szumsky/Low-Power-Internet-Radio/README.md

# Low-Power-Internet-Radio
projekt badawczy 22/23

na razie puściutko
