szumsky/Low-Power-Internet-Radio/hardware/105450-0101/105450-0101.step

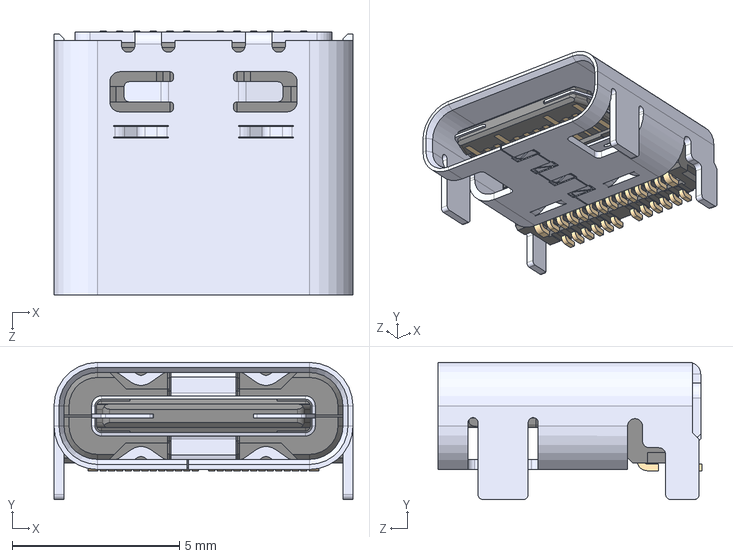
[picture p1: CAD file, 2022-08-20]
hardware/105450-0101/105450-0101.step
8.94 x 4.10 x 7.90 mm
