szumsky/Low-Power-Internet-Radio/(list of files, drawings)

Other design files:
hardware/reference/ESP32-DevKitC-V4_Reference_Design/02_PCB Layout/ESP32-DevKitC-V4_20171206A.pcb
