szumsky/Low-Power-Internet-Radio/hardware/radio.kicad_pcb

## KiCad design hardware/radio.kicad_pcb (2023-05-23)

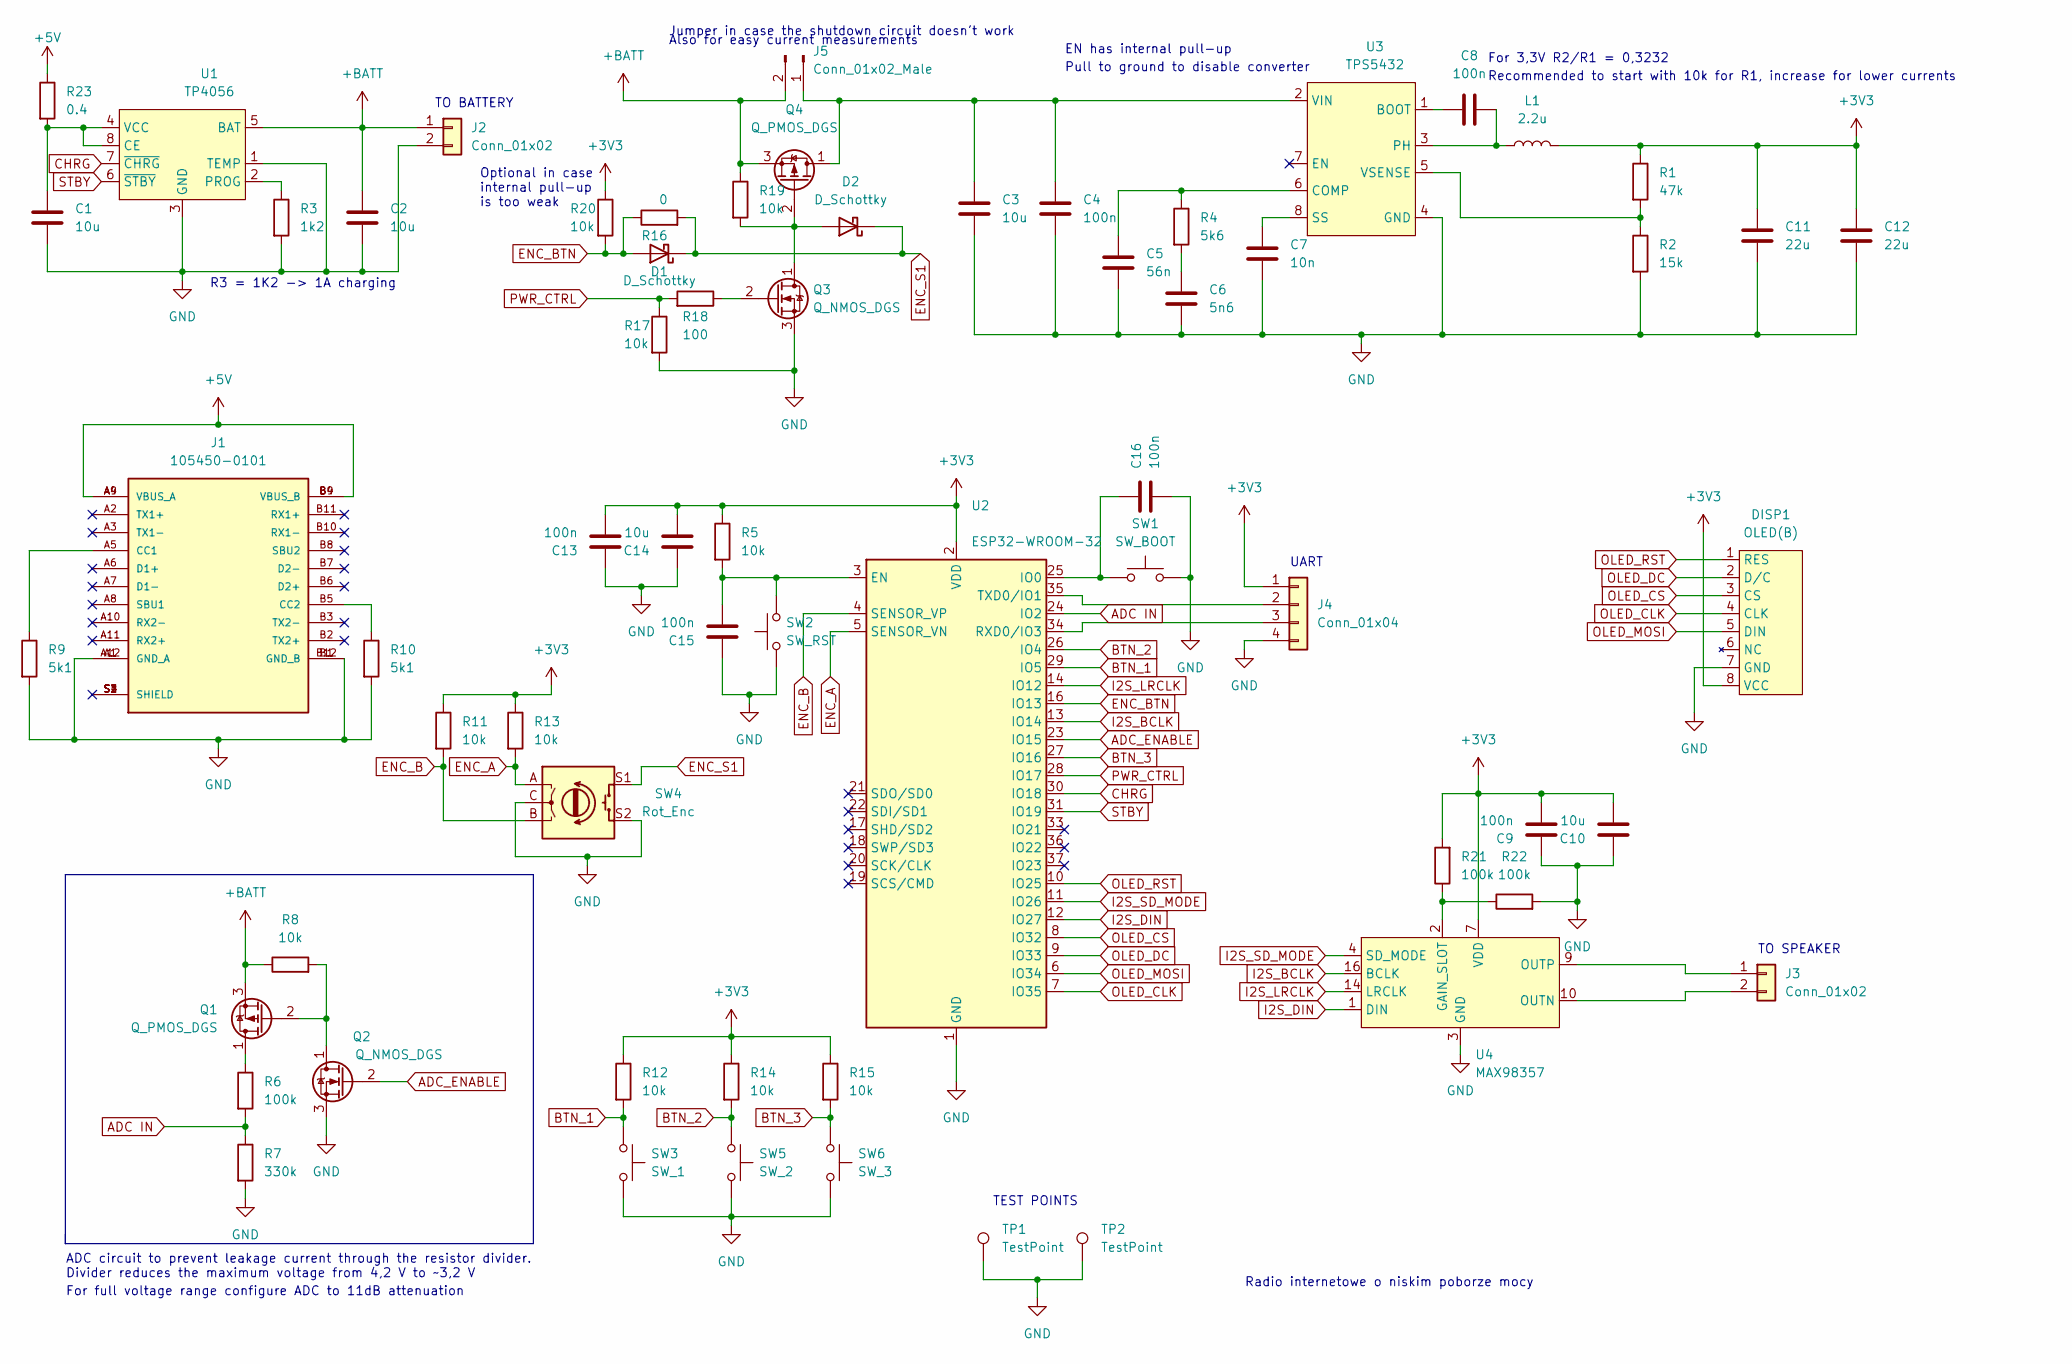
[picture p2: schematic radio.kicad_sch]

Parts:
C1, C2, C3, C10, C14: 10u; C_1206_3216Metric
C4, C9, C13, C15, C16: 100n; C_0603_1608Metric
C5: 56n; C_0603_1608Metric
C6: 5n6; C_0603_1608Metric
C7: 10n; C_0603_1608Metric
C8: 100n; C_0603_1608Metric; Voltage rating >10V
C11, C12: 22u; C_1206_3216Metric
D1, D2: D_Schottky; D_SMA
DISP1: OLED(B); waveshare_oled
J1: 105450-0101; MOLEX_105450-0101; PARTREV A7
J2, J3: Conn_01x02; PinHeader_1x02_P2.54mm_Vertical
J4: Conn_01x04; PinHeader_1x04_P2.54mm_Vertical
J5: Conn_01x02_Male; PinHeader_1x02_P2.54mm_Horizontal
L1: 2.2u; DJNR6028-2R2-S
Q1, Q4: Q_PMOS_DGS; SOT-23
Q2, Q3: Q_NMOS_DGS; SOT-23
R1: 47k; R_0603_1608Metric
R2: 15k; R_0603_1608Metric
R3: 1k2; R_0603_1608Metric
R4: 5k6; R_0603_1608Metric
R5, R8, R11, R12, R13, R14, R15, R17, R19, R20: 10k; R_0603_1608Metric
R6, R21, R22: 100k; R_0603_1608Metric
R7: 330k; R_0603_1608Metric
R9, R10: 5k1; R_0603_1608Metric
R16: 0; R_0603_1608Metric
R18: 100; R_0603_1608Metric
R23: 0.4; R_1210_3225Metric; Power rating 0.5 W
SW1: SW_BOOT; SW_Push_1P1T_NO_6x6mm_H9.5mm
SW2: SW_RST; SW_Push_1P1T_NO_6x6mm_H9.5mm
SW3: SW_1; SW_Push_1P1T_NO_6x6mm_H9.5mm
SW4: Rot_Enc; RotaryEncoder_Alps_EC12E-Switch_Vertical_H20mm_CircularMoun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
SW5: SW_2; SW_Push_1P1T_NO_6x6mm_H9.5mm
SW6: SW_3; SW_Push_1P1T_NO_6x6mm_H9.5mm
TP1, TP2: TestPoint; TestPoint_Loop_D2.50mm_Drill1.0mm
U1: TP4056; SOP-8-1EP_4.57x4.57mm_P1.27mm_EP4.57x4.45mm
U2: ESP32-WROOM-32
U3: TPS5432; TI_SO-PowerPAD-8
U4: MAX98357; TQFN-16-1EP_3x3mm_P0.5mm_EP1.23x1.23mm

Connections:
+3V3: C9.2, C10.2, C11.1, C12.1, C13.2, C14.2, DISP1.8 (VCC), J4.1, L1.2, R1.1, R5.1, R11.1, R12.1, R13.1, R14.1, R15.1, R20.1, R21.2, U2.2 (VDD), U4.7 (VDD)
+5V: J1.A4 (VBUS_A), J1.A9 (VBUS_A), J1.B4 (VBUS_B), J1.B9 (VBUS_B), R23.1
+BATT: C2.1, J2.1, J5.2, Q1.3 (S), Q4.3 (S), R8.1, R19.1, U1.5 (BAT)
ADC IN: R6.2, R7.1, U2.24 (IO2)
ADC_ENABLE: Q2.2 (G), U2.23 (IO15)
BTN_1: R12.2, SW3.1, U2.29 (IO5)
BTN_2: R14.2, SW5.1, U2.26 (IO4)
BTN_3: R15.2, SW6.1, U2.27 (IO16)
CHRG: U1.7 (~CHRG), U2.30 (IO18)
ENC_A: R13.2, SW4.A, U2.5 (SENSOR_VN)
ENC_B: R11.2, SW4.B, U2.4 (SENSOR_VP)
ENC_BTN: D1.2 (A), R16.1, R20.2, U2.16 (IO13)
ENC_S1: D1.1 (K), D2.1 (K), R16.2, SW4.S1
GND: C1.2, C2.2, C3.2, C4.2, C5.2, C6.2, C7.2, C9.1, C10.1, C11.2, C12.2, C13.1, C14.1, C15.1, C16.2, DISP1.7 (GND), J1.A1 (GND_A), J1.A12 (GND_A), J1.B1 (GND_B), J1.B12 (GND_B), J2.2, J4.4, Q2.3 (S), Q3.3 (S), R2.2, R3.2, R7.2, R9.2, R10.2, R17.2, R22.2, SW1.2, SW2.1, SW3.2, SW4.C, SW4.S2, SW5.2, SW6.2, TP1.1, TP2.1, U1.1 (TEMP), U1.3 (GND), U1.9, U2.1 (GND), U2.15 (GND), U2.38 (GND), U2.39 (GND), U3.4 (GND), U3.9, U4.3 (GND), U4.17
I2S_BCLK: U2.13 (IO14), U4.16 (BCLK)
I2S_DIN: U2.12 (IO27), U4.1 (DIN)
I2S_LRCLK: U2.14 (IO12), U4.14 (LRCLK)
I2S_SD_MODE: U2.11 (IO26), U4.4 (SD_MODE)
unnamed: C1.1, R23.2, U1.4 (VCC), U1.8 (CE)
unnamed: C3.1, C4.1, J5.1, Q4.1 (D), U3.2 (VIN)
unnamed: C5.1, R4.1, U3.6 (COMP)
unnamed: C6.1, R4.2
unnamed: C7.1, U3.8 (SS)
unnamed: C8.1, L1.1, U3.3 (PH)
unnamed: C8.2, U3.1 (BOOT)
unnamed: C15.2, R5.2, SW2.2, U2.3 (EN)
unnamed: C16.1, SW1.1, U2.25 (IO0)
unnamed: D2.2 (A), Q3.1 (D), Q4.2 (G), R19.2
unnamed: J1.A5 (CC1), R9.1
unnamed: J1.B5 (CC2), R10.1
unnamed: J3.1, U4.9 (OUTP)
unnamed: J3.2, U4.10 (OUTN)
unnamed: J4.2, U2.35 (TXD0/IO1)
unnamed: J4.3, U2.34 (RXD0/IO3)
unnamed: Q1.1 (D), R6.1
unnamed: Q1.2 (G), Q2.1 (D), R8.2
unnamed: Q3.2 (G), R18.1
unnamed: R1.2, R2.1, U3.5 (VSENSE)
unnamed: R3.1, U1.2 (PROG)
unnamed: R21.1, R22.1, U4.2 (GAIN_SLOT)
OLED_CLK: DISP1.4 (CLK), U2.7 (IO35)
OLED_CS: DISP1.3 (CS), U2.8 (IO32)
OLED_DC: DISP1.2 (D/C), U2.9 (IO33)
OLED_MOSI: DISP1.5 (DIN), U2.6 (IO34)
OLED_RST: DISP1.1 (RES), U2.10 (IO25)
PWR_CTRL: R17.1, R18.2, U2.28 (IO17)
STBY: U1.6 (~STBY), U2.31 (IO19)

Notes on the sheet:
Jumper in case the shutdown circuit doesn't work
Radio internetowe o niskim poborze mocy
Optional in case internal pull-up is too weak
TO BATTERY
ADC circuit to prevent leakage current through the resistor divider. Divider reduces the maximum voltage from 4,2 V to ~3,2 V
For full voltage range configure ADC to 11dB attenuation
Pull to ground to disable converter
Recommended to start with 10k for R1, increase for lower currents
R3 = 1K2 -> 1A charging
EN has internal pull-up
TEST POINTS
Also for easy current measurements
TO SPEAKER
For 3,3V R2/R1 = 0,3232
UART

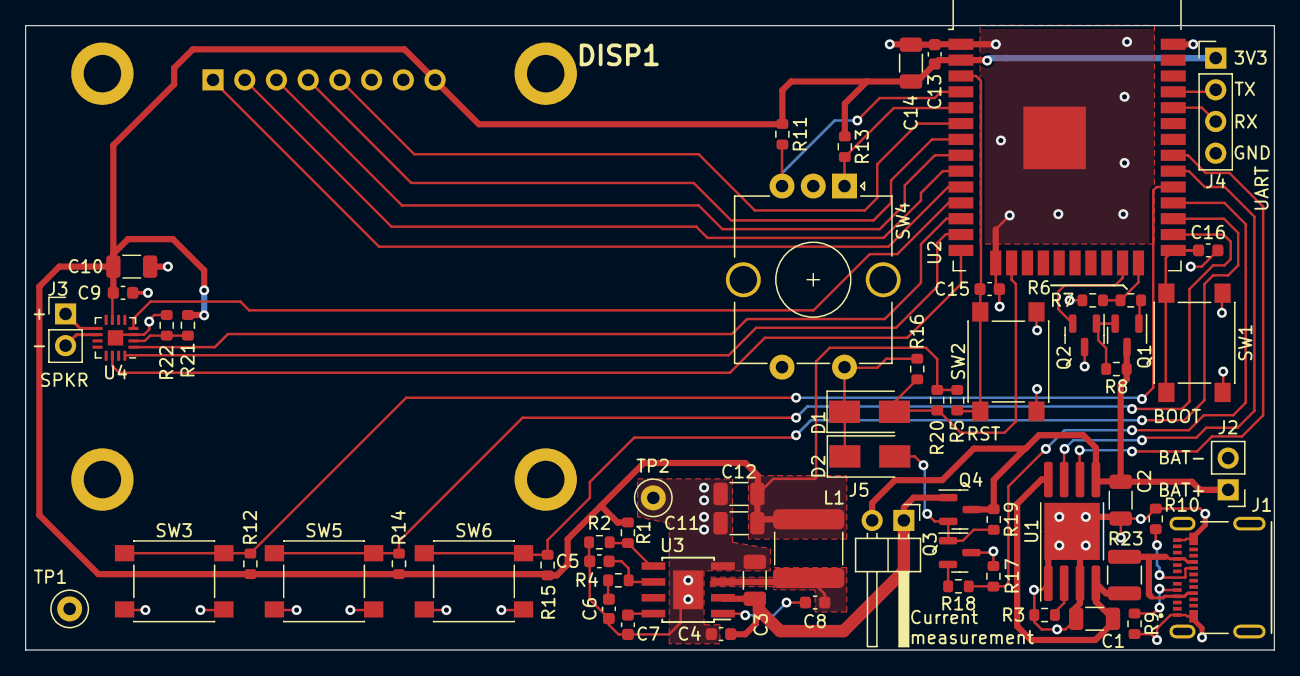
[picture p3: board radio.kicad_pcb from above]

Board: 2 copper layers, 100.0 x 50.0 mm, 64 parts (0 on the bottom side), 47 nets.
