szumsky/Low-Power-Internet-Radio/(commit log)

2022-04-26 dodano foldery dzielące na arduino i esp-idf
2022-04-28 Wrzucone arduino
2022-06-10 stworzono projekt hardware
    [radio.kicad_pcb, radio.kicad_sch]
2022-06-10 stworzony symbol MAX98357
    [radio.kicad_sch]
2022-06-10 utworzono symbol TPS5432
    [radio.kicad_sch]
2022-06-10 dodano ESP32-WROOM-32 na schemacie
    [radio.kicad_sch]
2022-06-11 aktualizacja opisu symbolu OLED
    [radio.kicad_sch]
2022-06-11 stworzono footprint wyswietlacza oled
2022-06-11 przypisano footprint wyswietlacza do symbolu
    [radio.kicad_sch]
2022-06-11 NETy zasilania i routing TP4056
    [radio.kicad_sch]
2022-08-21 added reference
    [ESP32-DevKitC-V4-(ESP32-SOLO-1)-BOMList(V1.2)-20180621A.xlsx, ESP32-DevKitC-V4-(ESP32-WROOM-32)-BOMList(V1.1)-20180607A.xlsx, ESP32-DevKitC-V4-(ESP32-WROOM-32D)-BOMList(V1.1)-20180607A.xlsx, ESP32-DevKitC-V4-(ESP32-WROOM-32U)-BOMList(V1.1)-20180607A.xlsx, ESP32-DevKitC-V4_20171206A.pcb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]
2022-08-22 added to schematic: rotary encoder, buttons, USB-C receptacle CC resistors
    [radio.kicad_sch]
2022-08-25 added shutdown circuit
    [radio.kicad_sch]
2022-08-27 began placement
    [radio.kicad_pcb, radio.kicad_sch]
2022-08-29 placement (possibly close to final)
    [radio.kicad_pcb, radio.kicad_sch]
2022-08-29 placement and some routing
    [radio.kicad_pcb]
2022-09-02 board finished (?)
    [radio.kicad_pcb]
2022-09-04 fixed DRC violations, added silkscreen legend
    [radio.kicad_pcb, radio.kicad_sch]
2022-09-17 made oled mounting point pads bigger
    [radio.kicad_pcb]
2022-10-16 Fixed C8 connection from BOOT-GND to BOOT-PH
    [radio.kicad_pcb, radio.kicad_sch]
2022-10-16 Added 0.4 ohm 0.5 W resistor to TP4056 to help with power dissipation
    [radio.kicad_pcb, radio.kicad_sch]
2022-10-23 adjusted silkscreen and some vias to improve labeling consistency and readability
    [radio.kicad_pcb]
2022-10-23 added copper fill cutout to the speaker connector and adjusted the 3V3 power trace near it to reduce potential proximity/ground-plane induced crosstalk
    [radio.kicad_pcb]
2022-10-23 added 'Current measurement' and 'UART' labels to J5 and J4 respectively
    [radio.kicad_pcb]
2022-10-23 Added project description to bottom silkscreen
    [radio.kicad_pcb]
2022-10-23 added test points; corrected C5 silkscreen again
    [radio.kicad_sch]
2022-10-23 redone DC-DC converter layout to match the reference in datasheet
    [radio.kicad_pcb, radio.kicad_sch]
2022-10-23 removed copper pour on signal layer because Eric Bogatin said so
    [radio.kicad_pcb]
2023-05-23 Add files via upload
    Arduino code for nvs flash management. Use for hardcoding ssid password pairs and radio stations url.
2023-05-23 Arduino code for nvs flash management. Hardcode ssid, password, radio stations.
2023-05-23 Arduino code for nvs flash management.
    Use for hardcoding ssid password pairs, radio stations.
    Check contents of nvs flash.
2023-05-23 Arduino code for erasing flash
    Use to wipe all data added using preferences library.
2023-05-23 Arduino code for LowPowerESP32WebRadio
    Needs modified version of ESP32AudioI2S library.
2023-05-23 removed irrelevant jumper (J5) comment
    [radio.kicad_sch]
2023-05-23 Mark R16 as not mounted
    [radio.kicad_sch]
2023-05-23 Added KNOWN_ISSUES.txt and marked known issues on schematic.
    [radio.kicad_sch]
2023-05-23 Added OLED module link to symbol.
    [radio.kicad_sch]
